gligli/juno-chorus-clone/README.md

juno-chorus-clone
=================

Roland Juno-60 chorus board clone
