gligli/juno-chorus-clone/juno-chorus-clone.kicad_pcb

## KiCad design juno-chorus-clone.kicad_pcb (2014-05-07)

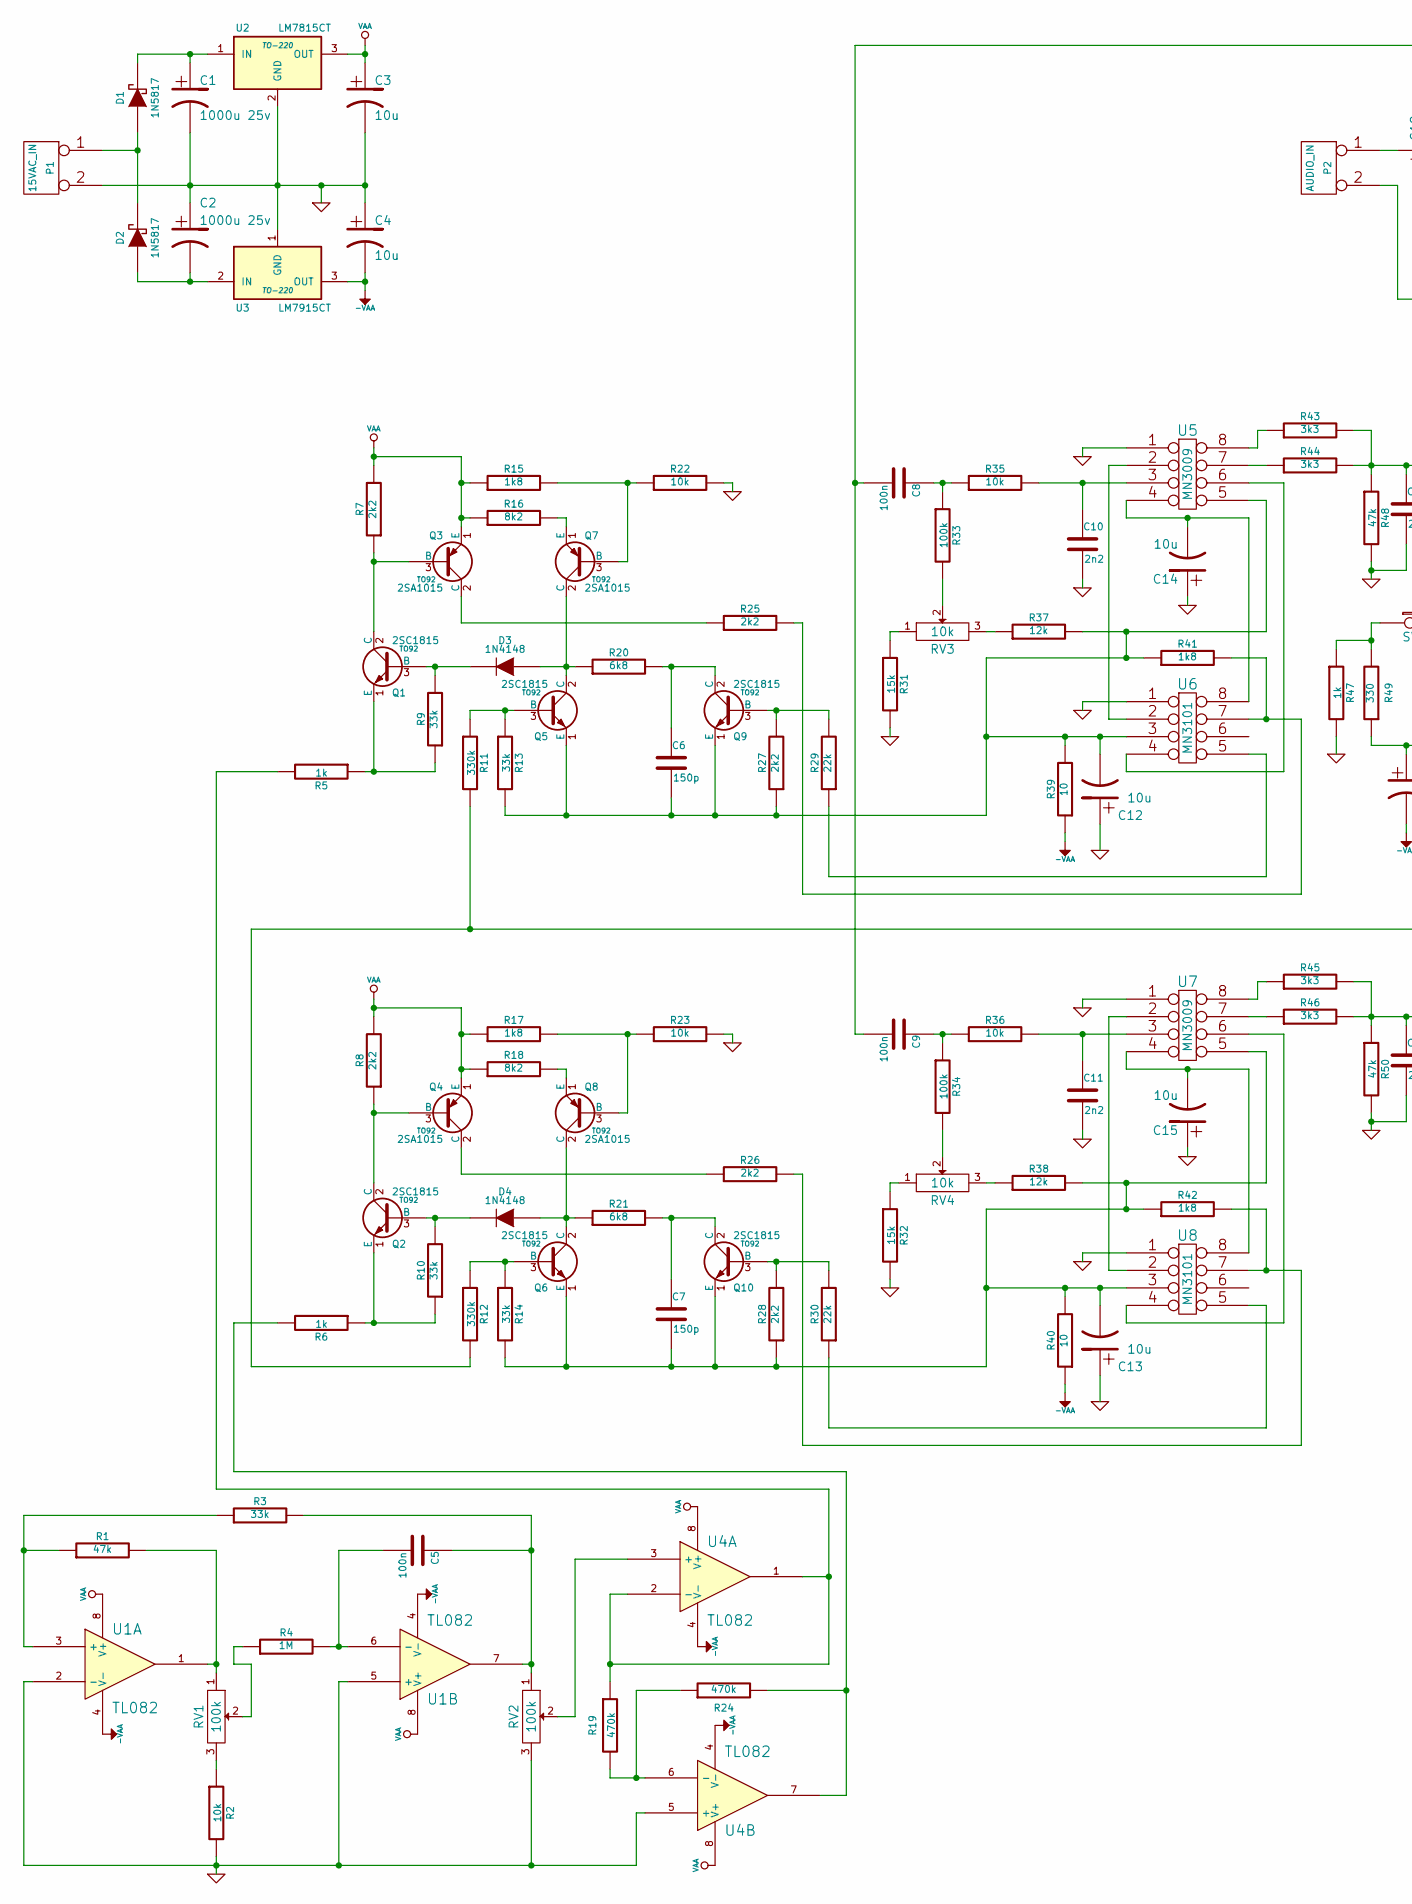
[picture p1: schematic juno-chorus-clone.sch, Roland Juno-60 chorus board clone, part in row 1, column 1]

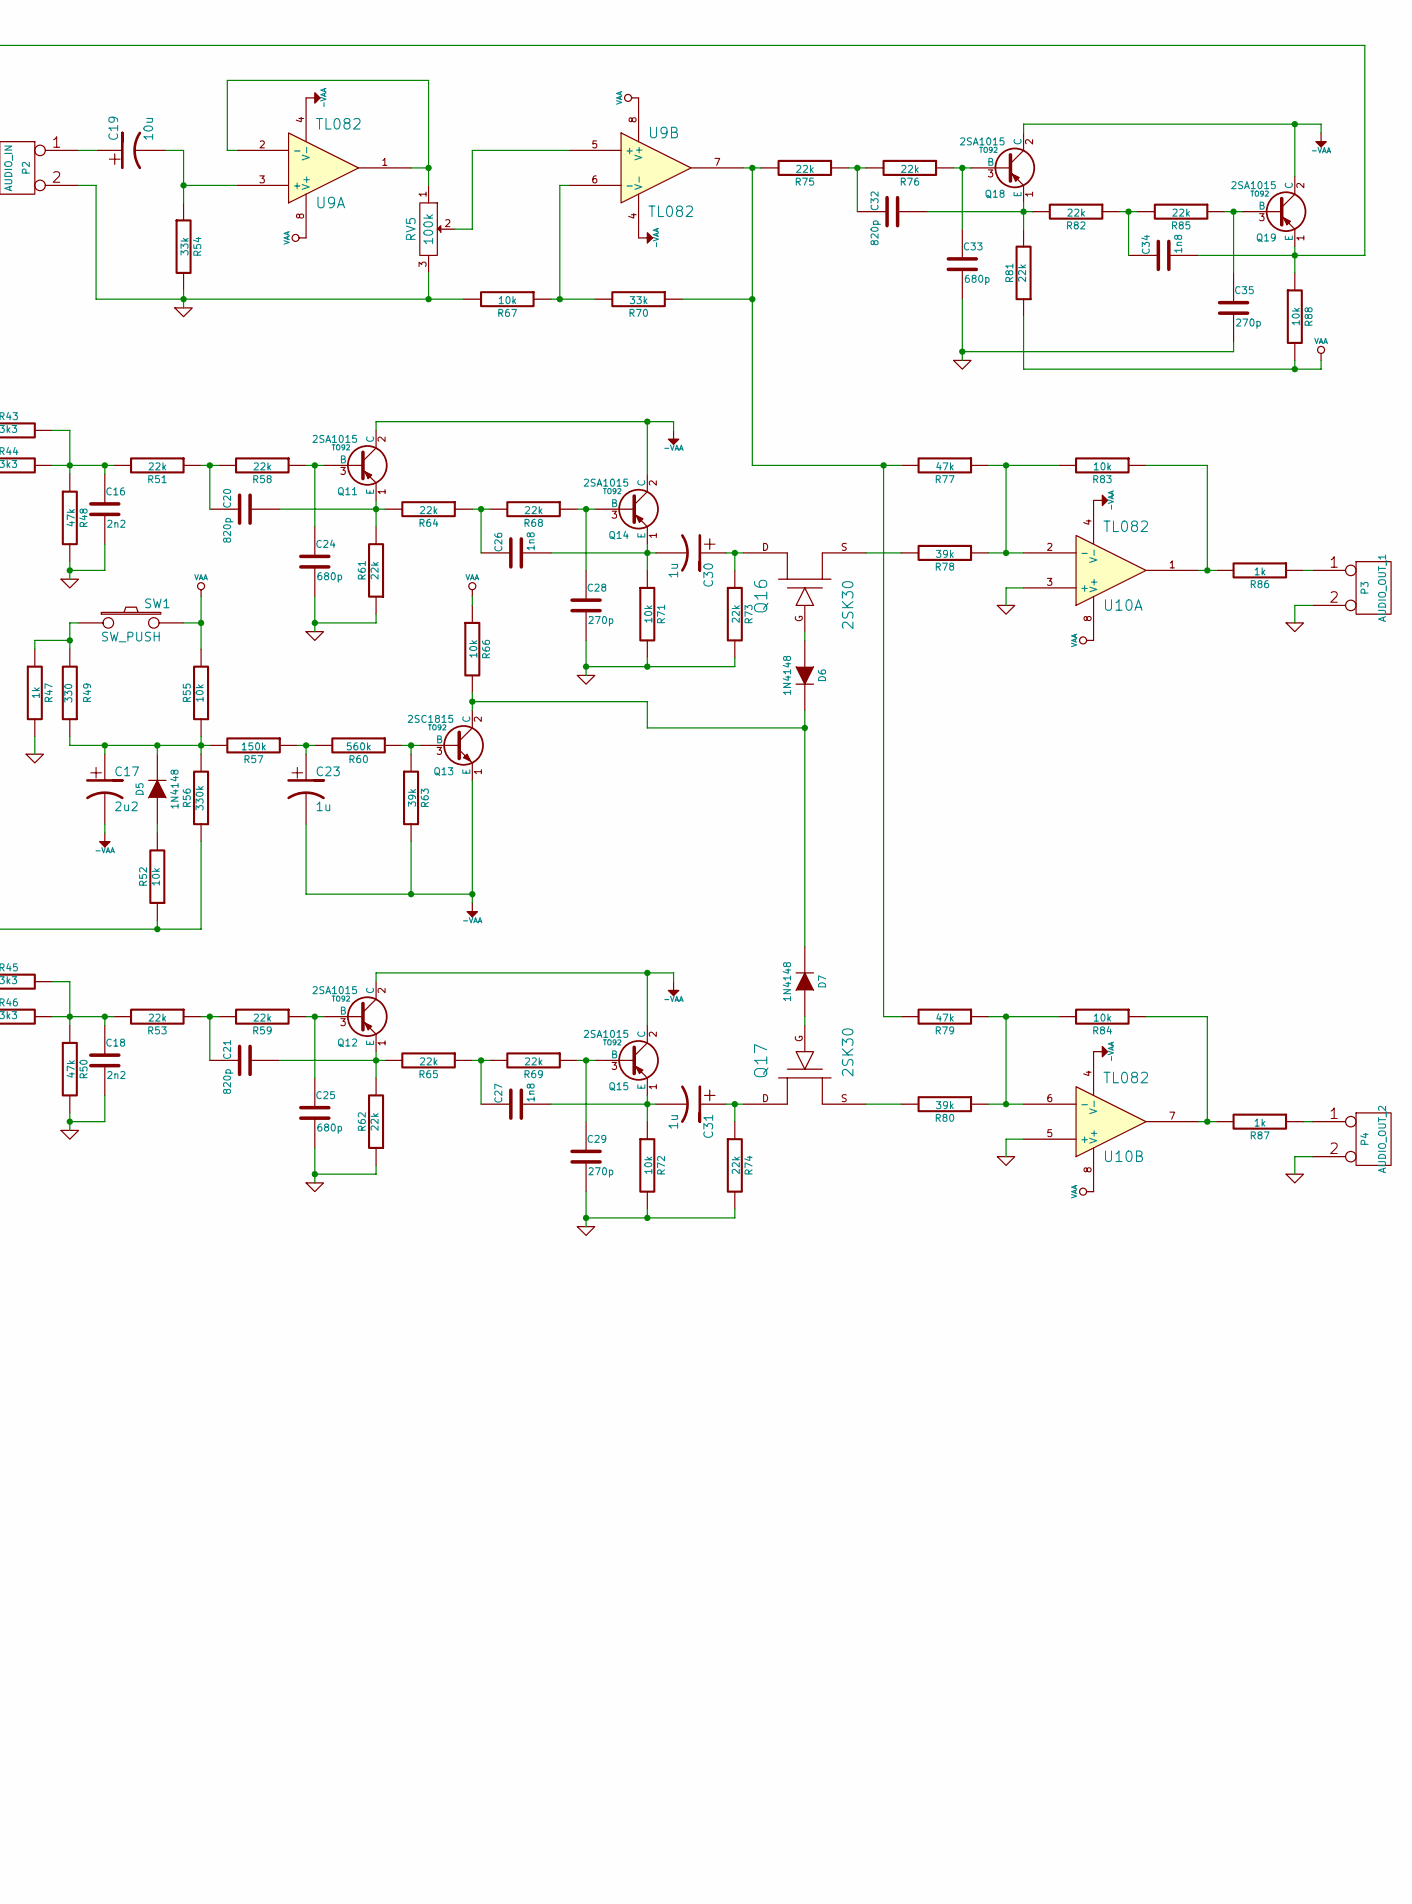
[picture p2: schematic juno-chorus-clone.sch, Roland Juno-60 chorus board clone, part in row 1, column 2]

Parts:
C1, C2: 1000u 25v
C3, C4, C12, C13, C14, C15, C19: 10u
C5, C8, C9: 100n
C6, C7: 150p
C10, C11, C16, C18: 2n2
C17: 2u2
C20, C21, C32: 820p
C23, C30, C31: 1u
C24, C25, C33: 680p
C26, C27, C34: 1n8
C28, C29, C35: 270p
D1, D2: 1N5817
D3, D4, D5, D6, D7: 1N4148
P1: 15VAC_IN
P2: AUDIO_IN
P3: AUDIO_OUT_1
P4: AUDIO_OUT_2
Q1, Q2, Q5, Q6, Q9, Q10, Q13: 2SC1815; TO92
Q3, Q4, Q7, Q8, Q11, Q12, Q14, Q15, Q18, Q19: 2SA1015; TO92
Q16, Q17: 2SK30
R1, R48, R50, R77, R79: 47k
R2, R22, R23, R35, R36, R52, R55, R66, R67, R71, R72, R83, R84, R88: 10k
R3, R9, R10, R13, R14, R54, R70: 33k
R4: 1M
R5, R6, R47, R86, R87: 1k
R7, R8, R25, R26, R27, R28: 2k2
R11, R12, R56: 330k
R15, R17, R41, R42: 1k8
R16, R18: 8k2
R19, R24: 470k
R20, R21: 6k8
R29, R30, R51, R53, R58, R59, R61, R62, R64, R65, R68, R69, R73, R74, R75, R76, R81, R82, R85: 22k
R31, R32: 15k
R33, R34: 100k
R37, R38: 12k
R39, R40: 10
R43, R44, R45, R46: 3k3
R49: 330
R57: 150k
R60: 560k
R63, R78, R80: 39k
RV1, RV2, RV5: 100k
RV3, RV4: 10k
SW1: SW_PUSH
U1, U4, U9, U10: TL082
U2: LM7815CT; TO-220
U3: LM7915CT; TO-220
U5, U7: MN3009
U6, U8: MN3101

Connections:
-VAA: C4.2, C17.2, C23.2, Q11.2 (C), Q12.2 (C), Q13.1 (E), Q14.2 (C), Q15.2 (C), Q18.2 (C), Q19.2 (C), R39.1, R40.1, R63.2, U1.4 (V-), U3.3 (OUT), U4.4 (V-), U9.4 (V-), U10.4 (V-)
GND: C1.2, C2.1, C3.2, C4.1, C10.2, C11.2, C12.1, C13.1, C14.1, C15.1, C16.2, C18.2, C24.2, C25.2, C28.2, C29.2, C33.2, C35.2, P1.2 (PM), P2.2 (PM), P3.2 (PM), P4.2 (PM), R2.2, R22.2, R23.2, R31.2, R32.2, R47.2, R48.2, R50.2, R54.2, R61.1, R62.1, R67.2, R71.2, R72.2, R73.2, R74.2, RV2.3, RV5.3, U1.2 (-), U1.5 (+), U2.2 (GND), U3.1 (GND), U4.5 (+), U5.1, U6.1, U7.1, U8.1, U10.3 (+), U10.5 (+)
unnamed: U5.2, U6.2
unnamed: R37.1, RV3.3
unnamed: R25.2, R41.2, U6.7
unnamed: C6.1, Q9.2 (C), R20.2
unnamed: Q5.3 (B), R11.1, R13.1
unnamed: R31.1, RV3.1
unnamed: R29.1, U6.5
unnamed: Q7.3 (B), R15.2, R22.1
unnamed: Q9.3 (B), R27.2, R29.2
unnamed: Q7.1 (E), R16.2
unnamed: C6.2, C12.2, Q5.1 (E), Q9.1 (E), R13.2, R27.1, R37.2, R39.2, R41.1, U5.5, U6.3
unnamed: D3.2 (K), Q1.3 (B), R9.2
unnamed: Q3.2 (C), R25.1
unnamed: D3.1 (A), Q5.2 (C), Q7.2 (C), R20.1
unnamed: Q1.2 (C), Q3.3 (B), R7.1
unnamed: C27.1, R65.1, R69.2
unnamed: C29.1, Q15.3 (B), R69.1
unnamed: C27.2, C31.2, Q15.1 (E), R72.1
unnamed: C21.2, Q12.1 (E), R62.2, R65.2
unnamed: C21.1, R53.1, R59.2
unnamed: C31.1, Q17.D, R74.1
unnamed: R84.1, R87.2, U10.7
unnamed: C25.1, Q12.3 (B), R59.1
unnamed: Q1.1 (E), R5.1, R9.1
unnamed: R79.1, R80.1, R84.2, U10.6 (-)
unnamed: P4.1, R87.1
unnamed: C14.2, U5.4, U6.8
unnamed: P3.1, R86.1
unnamed: C33.1, Q18.3 (B), R76.1
unnamed: C20.1, R51.1, R58.2
unnamed: R83.1, R86.2, U10.1
unnamed: R77.1, R78.1, R83.2, U10.2 (-)
unnamed: C19.1, P2.1
unnamed: R70.1, R75.2, R77.2, R79.2, U9.7
unnamed: R67.1, R70.2, U9.6 (-)
unnamed: C32.1, R75.1, R76.2
unnamed: RV5.2, U9.5 (+)
unnamed: RV5.1, U9.1, U9.2 (-)
unnamed: C35.1, Q19.3 (B), R85.1
unnamed: C34.1, R82.1, R85.2
unnamed: C20.2, Q11.1 (E), R61.2, R64.2
unnamed: C32.2, Q18.1 (E), R81.2, R82.2
unnamed: C16.1, R43.2, R44.2, R48.1, R51.2
unnamed: R33.2, RV3.2
unnamed: R43.1, U5.8
unnamed: R44.1, U5.7
unnamed: C10.1, R35.2, U5.3
unnamed: U5.6, U6.4
unnamed: C8.1, R33.1, R35.1
unnamed: C24.1, Q11.3 (B), R58.1
unnamed: C26.1, R64.1, R68.2
unnamed: C28.1, Q14.3 (B), R68.1
unnamed: C26.2, C30.2, Q14.1 (E), R71.1
unnamed: C30.1, Q16.D, R73.1
unnamed: D6.1 (A), Q16.G
unnamed: Q16.S, R78.2
unnamed: Q17.S, R80.2
unnamed: D5.1 (A), R52.2
unnamed: R11.2, R12.2, R52.1, R56.1
unnamed: D6.2 (K), D7.2 (K), Q13.2 (C), R66.2
unnamed: R47.1, R49.2, SW1.1
unnamed: C8.2, C9.2, C34.2, Q19.1 (E), R88.1
unnamed: C23.1, R57.1, R60.2
unnamed: Q13.3 (B), R60.1, R63.1
unnamed: C17.1, D5.2 (K), R49.1, R55.1, R56.2, R57.2
unnamed: Q8.1 (E), R18.2
unnamed: Q4.2 (C), R26.1
unnamed: R6.2, R24.2, U4.7
unnamed: R19.2, R24.1, U4.6 (-)
unnamed: Q2.1 (E), R6.1, R10.1
unnamed: U7.6, U8.4
unnamed: D4.1 (A), Q6.2 (C), Q8.2 (C), R21.1
unnamed: Q2.2 (C), Q4.3 (B), R8.1
unnamed: C11.1, R36.2, U7.3
unnamed: R45.1, U7.8
unnamed: R46.1, U7.7
unnamed: R34.2, RV4.2
unnamed: C9.1, R34.1, R36.1
unnamed: D7.1 (A), Q17.G
unnamed: U7.2, U8.2
unnamed: D4.2 (K), Q2.3 (B), R10.2
unnamed: C18.1, R45.2, R46.2, R50.1, R53.2
unnamed: Q10.3 (B), R28.2, R30.2
unnamed: R26.2, R42.2, U8.7
unnamed: R32.1, RV4.1
unnamed: R30.1, U8.5
unnamed: Q8.3 (B), R17.2, R23.1
unnamed: RV2.2, U4.3 (+)
unnamed: C15.2, U7.4, U8.8
unnamed: C7.1, Q10.2 (C), R21.2
unnamed: Q6.3 (B), R12.1, R14.1
unnamed: R38.1, RV4.3
unnamed: C7.2, C13.2, Q6.1 (E), Q10.1 (E), R14.2, R28.1, R38.2, R40.2, R42.1, U7.5, U8.3
unnamed: R2.1, RV1.3
unnamed: C5.1, R3.2, RV2.1, U1.7
unnamed: R4.1, RV1.2
unnamed: C2.2, D2.1 (A), U3.2 (IN)
unnamed: D1.1 (A), D2.2 (K), P1.1
unnamed: R1.2, RV1.1, U1.1
unnamed: C1.1, D1.2 (K), U2.1 (IN)
unnamed: R5.2, R19.1, U4.1, U4.2 (-)
unnamed: C19.2, R54.1, U9.3 (+)
unnamed: C5.2, R4.2, U1.6 (-)
unnamed: R1.1, R3.1, U1.3 (+)
VAA: C3.1, Q3.1 (E), Q4.1 (E), R7.2, R8.2, R15.1, R16.1, R17.1, R18.1, R55.2, R66.1, R81.1, R88.2, SW1.2, U1.8 (V+), U2.3 (OUT), U4.8 (V+), U9.8 (V+), U10.8 (V+)

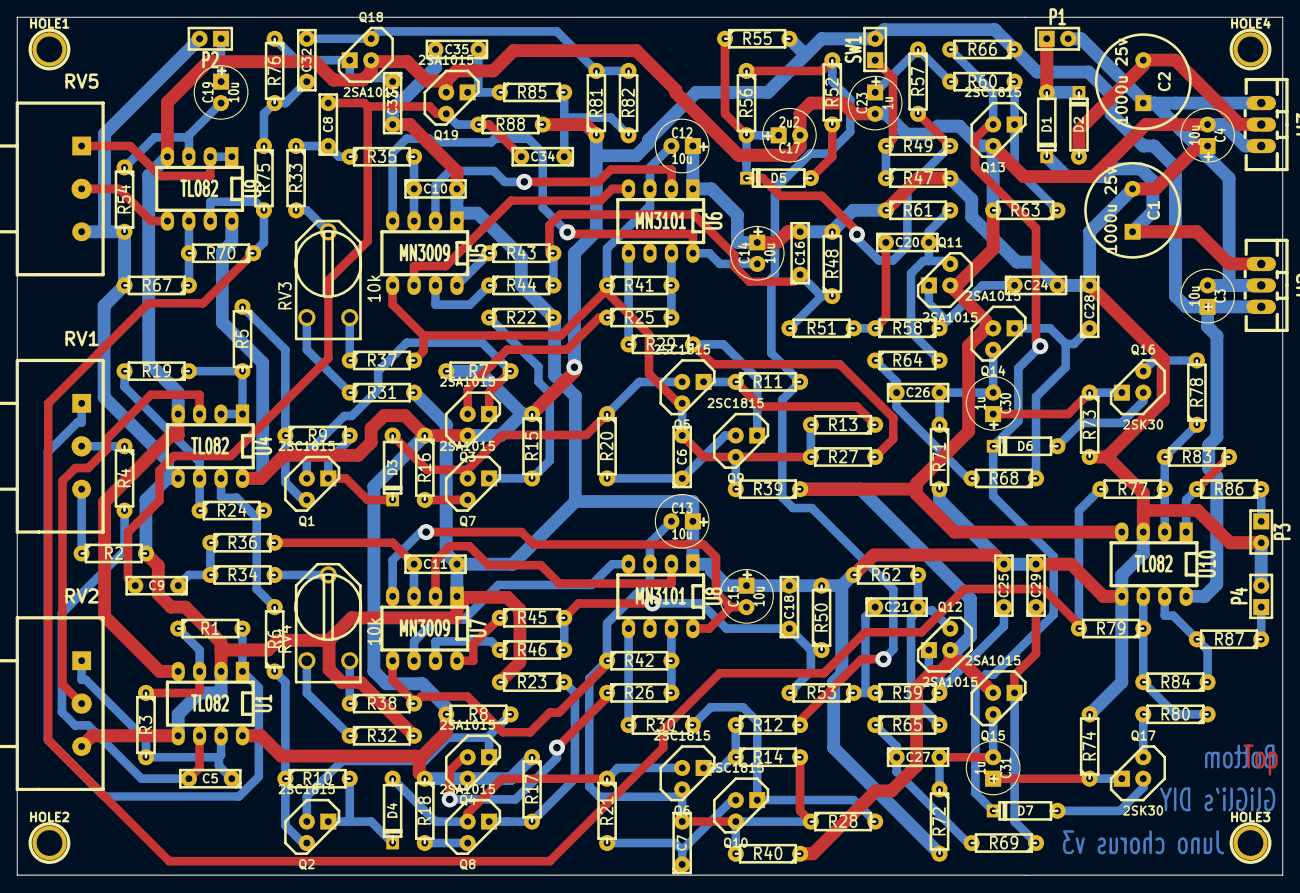
[picture p3: board juno-chorus-clone.kicad_pcb from above]

Board: 2 copper layers, 149.9 x 101.6 mm, 172 parts (0 on the bottom side), 107 nets.

Other parts of the board:
HOLE1, HOLE2, HOLE3, HOLE4: P***; 1pin
