gligli/juno-chorus-clone/(commit log)

2014-04-21 Adding kicad project and unverified schematics
    [juno-chorus-clone.sch]
2014-04-21 schematics fixes
    [juno-chorus-clone.sch]
2014-04-21 missing names
    [juno-chorus-clone.sch]
2014-04-21 fix transistors pinouts
    [juno-chorus-clone.sch]
2014-04-21 adding netlist -- start of PCB
    [juno-chorus-clone.kicad_pcb]
2014-04-21 start of PCB placement
    [juno-chorus-clone.kicad_pcb]
2014-05-02 pcb placement
    [juno-chorus-clone.kicad_pcb]
2014-05-02 PCB v1
    [juno-chorus-clone.kicad_pcb]
2014-05-03 schematics: fixes to make it work (tested)
    [juno-chorus-clone.sch]
2014-05-04 pcb: v2 with post-debug fixes, should be ok to build
    [juno-chorus-clone.kicad_pcb, juno-chorus-clone.sch]
2014-05-04 sch: fixing wrong res values in BBDs output stages
    [juno-chorus-clone.kicad_pcb, juno-chorus-clone.sch]
2014-05-07 sch: output level / input gain pot fixes
    [juno-chorus-clone.kicad_pcb, juno-chorus-clone.sch]
2014-07-23 adding BOM
2015-09-12 1N5817 -> 1N5819 (1N5817 can't handle 15VAC)
    [juno-chorus-clone.sch]
